Syar02/Hidroponik/docs/mode_lte_a7670e/Skema_Mode_LTE_A7670E.jpg

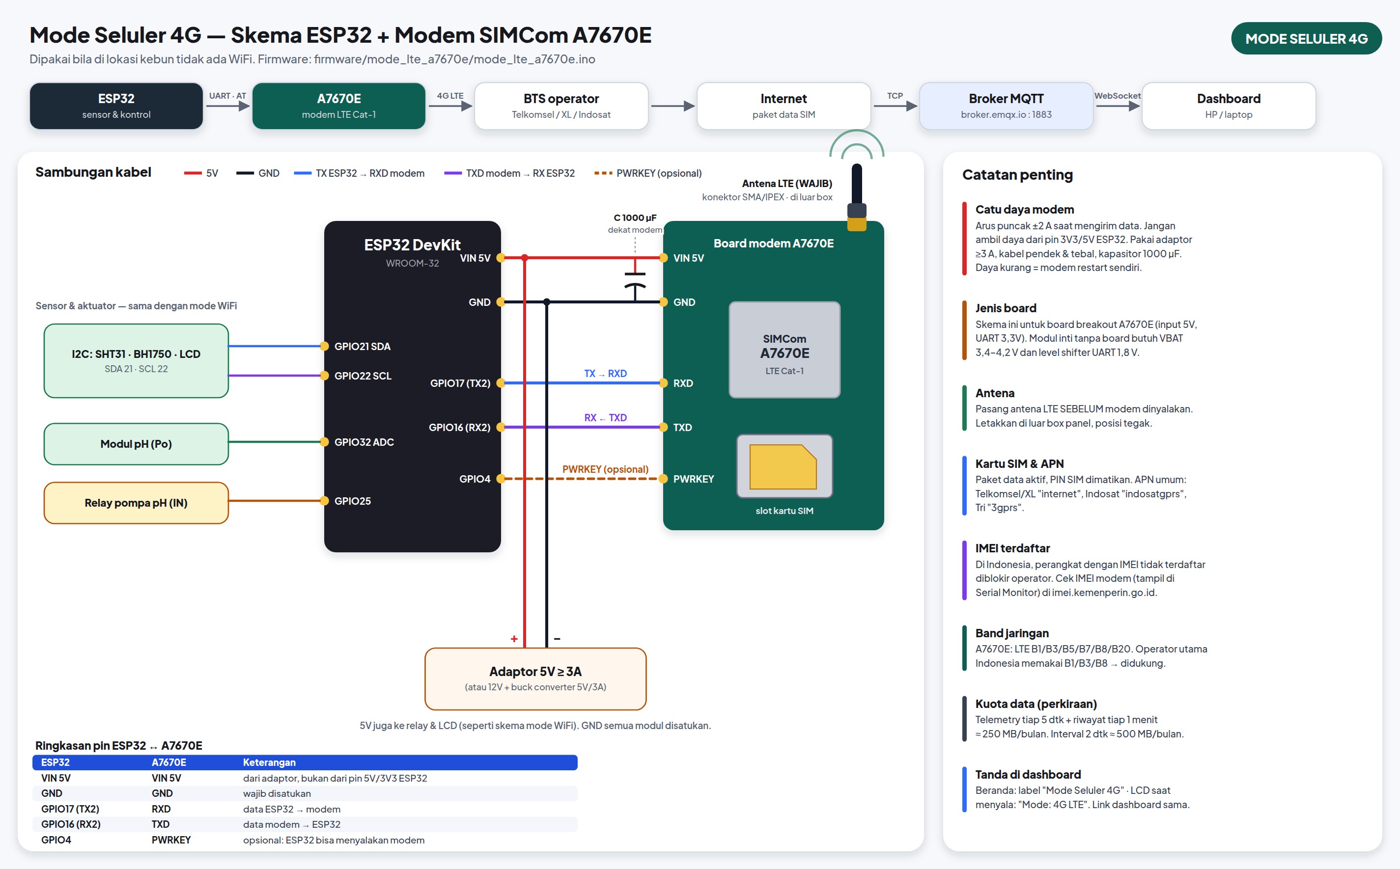
docs/mode_lte_a7670e/Skema_Mode_LTE_A7670E.jpg
