Syar02/Hidroponik/docs/mode_otomatis/Skema_Mode_Otomatis.jpg

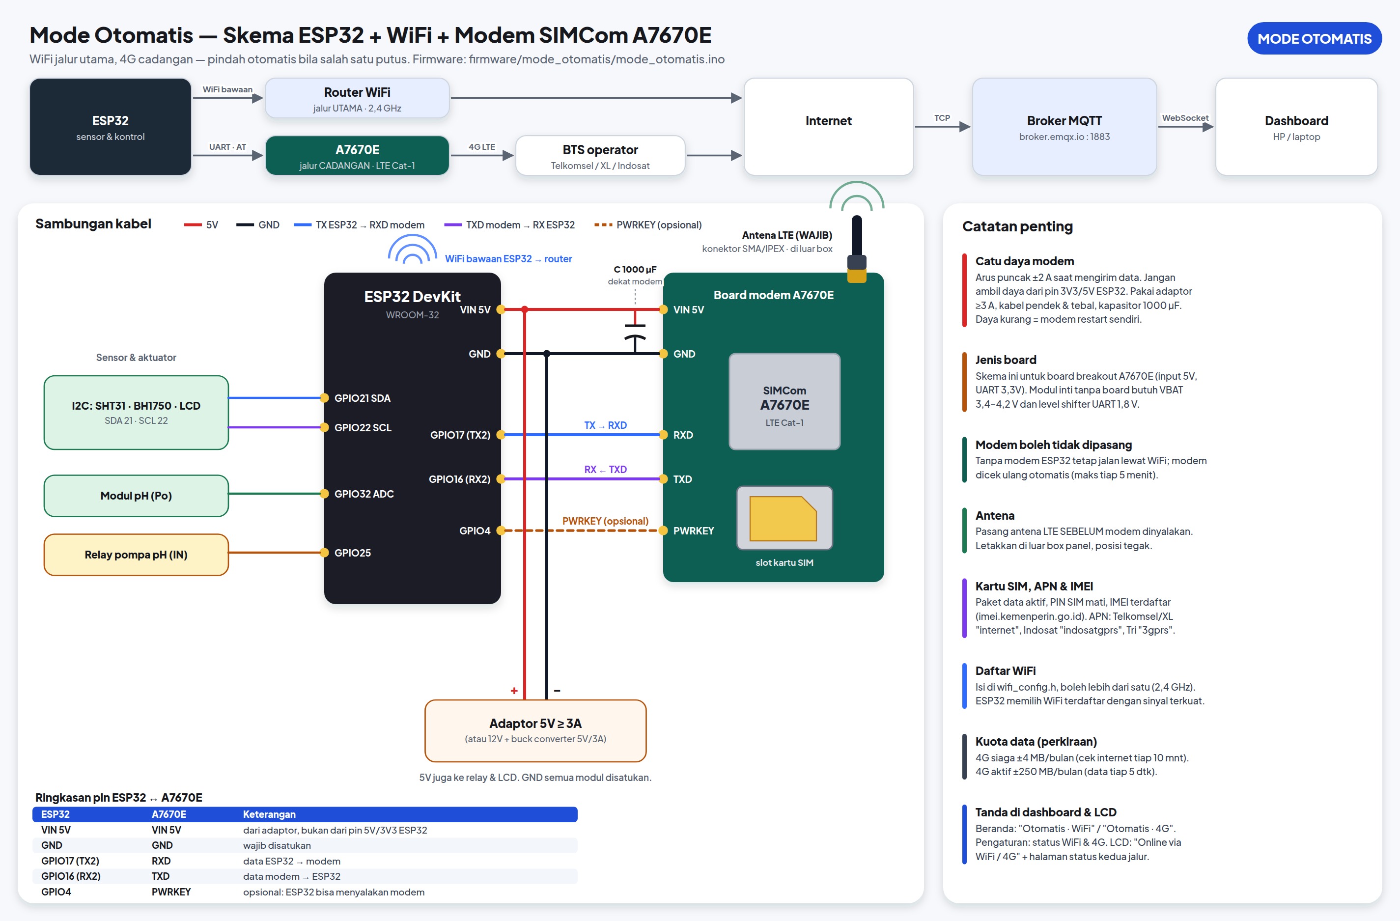
docs/mode_otomatis/Skema_Mode_Otomatis.jpg
