Syar02/Hidroponik/docs/mode_wifi/Skema_Mode_WiFi.jpg

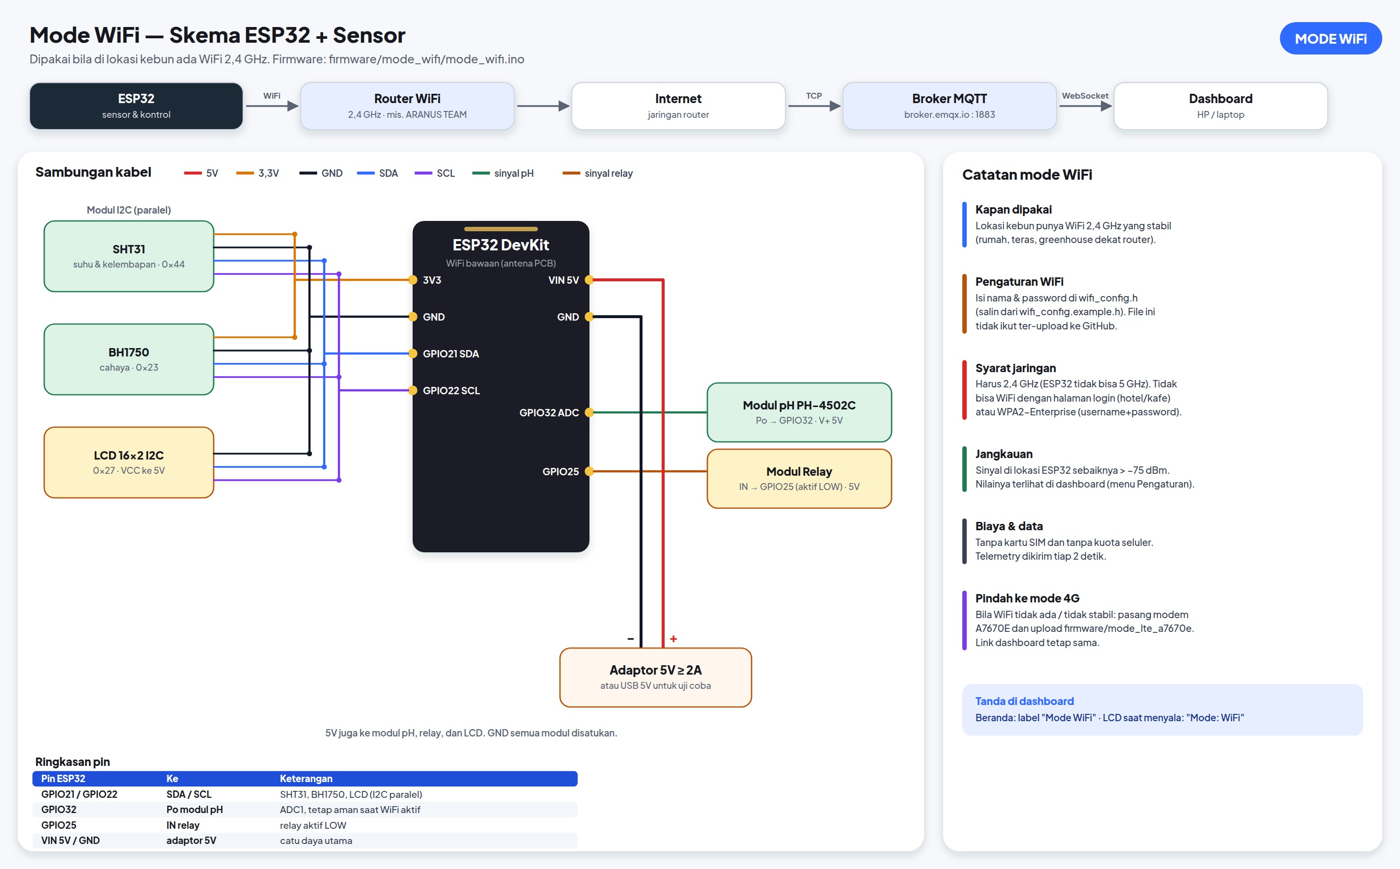
docs/mode_wifi/Skema_Mode_WiFi.jpg
