Syar02/Hidroponik/firmware/mode_wifi/wifi_config.example.h

// Salin file ini menjadi "wifi_config.h" lalu isi nama & password WiFi (2,4 GHz).
// wifi_config.h diabaikan git sehingga password tidak ikut ter-upload ke GitHub.
#pragma once
const char* WIFI_SSID   = "NAMA_WIFI";
const char* WIFI_PASS   = "PASSWORD_WIFI";
